Kruemelbahn/LightControl/README.md

# LightControl

...ist eine kleine Sammlung von Lichtsteuerungen (mit analoger Ansteuerung) auf meiner Modellbahn.

Nachfolgende Softwarepakete stehen unter [Software](https://github.com/Kruemelbahn/lightControl/tree/main/Software) zur Verfügung
- auf Arduino-Basis, kompiliert für ATtiny13 (für die Arduino-IDE wird das Board [MicroCore](https://github.com/MCUdude/MicroCore) verwendet):
  - [Blinken_5fach](https://github.com/Kruemelbahn/lightControl/tree/main/Software/Blinken_5fach) läßt alle Ausgänge blinken
  - [Einsatzfahrzeuge](https://github.com/Kruemelbahn/lightControl/tree/main/Software/Einsatzfahrzeuge) generiert zwei verschiedene Blinkfolgen für Einsatzfahrzeuge
- auf ATtiny13-Basis:
  - [Belebtes_Haus_mit_TV_Attiny](https://github.com/Kruemelbahn/lightControl/tree/main/Software/Belebtes_Haus_mit_TV_Attiny) simuliert ein belebtes Haus, es werden einige LEDs zufällig eine- und ausgeschaltet (Zimmerbeleuchtung), ein weiterer Ausgang simuliert einen flimmernden Fernsehgerät.
  - [Blinken](https://github.com/Kruemelbahn/lightControl/tree/main/Software/Blinken) läßt den Ausgang PB0 blinken
  - [Blitz_Blinker](https://github.com/Kruemelbahn/lightControl/tree/main/Software/Blitz_Blinker) ist die Implementierung des [FotoMichel](https://github.com/Kruemelbahn/FotoMichel) auf AVR-Basis anstelle eines PIC.
    Die Hardware ist gegenüber dem originalen FotoMichel einfacher gehalten und hat nur einen Triggereingang für die Blitzlichter.
	Sowohl die Software für den [Blitz_Blinker](https://github.com/Kruemelbahn/lightControl/tree/main/Software/Blitz_Blinker) als auch des [FotoMichel](https://github.com/Kruemelbahn/FotoMichel) sind auf diesem Lichtcomputer mit geringen Hardwareanpassungen einsetzbar, siehe in der [Dokumentation](Documentation/Lichtcomputer.pdf).
  - [LaufLicht_ATiny13](https://github.com/Kruemelbahn/LightControl/tree/main/Software/LaufLicht_ATiny13) ist die Implementierung eines Lauflichts über die Ausgänge PB0...PB4

Einige im Repository [Signalling](https://github.com/Kruemelbahn/Signalling) befindliche Softwarepakete sind auch auf dem Lichtcomputer einsetzbar. Anwendung und Einschränkungen bzw. Änderungen sind in der [Dokumentation](https://github.com/Kruemelbahn/LightControl/blob/main/Documentation/Lichtcomputer.pdf) enthalten.

Der Quellcode wird nur benötigt, wenn
- man neugierig ist
- oder den Quellcode ändern und somit neu kompilieren möchte.
Zum Kompilieren wird ein AVR-Compiler (z.B. das ATMEL-Studio bzw. die Arduino-IDE) benötigt.

Ansonsten reichen die Hex-Dateien völlig aus, diese werden in den ATtiny13 geflasht.
Die Software auf dem ATtiny13 läuft mit den Default-Fuses: low=0x6A high=0xFF

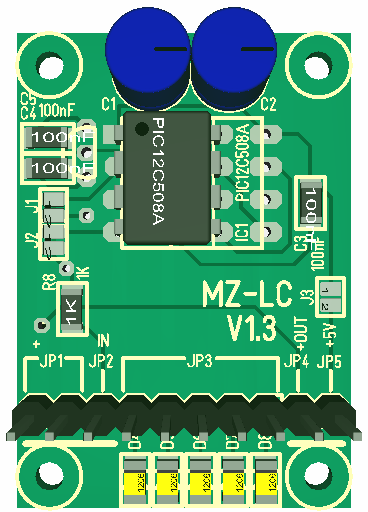
[picture p1: Images/Lichtcomputer(PIC).png]
Lichtcomputer mit PIC

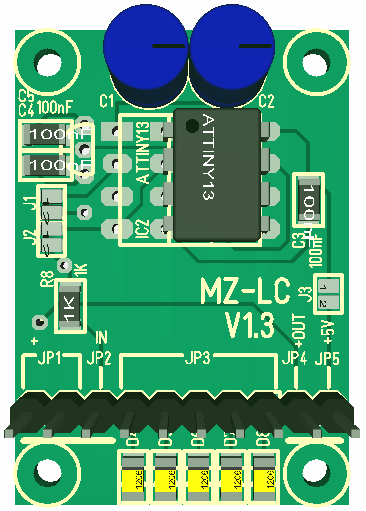
[picture p2: Images/Lichtcomputer(ATMEL).png]
Lichtcomputer mit ATTiny

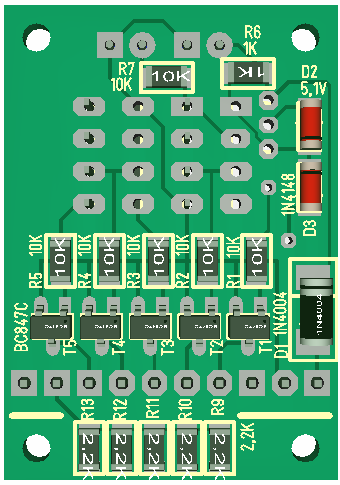
[picture p3: Images/Lichtcomputer(Unterseite).png]
Lichtcomputer (Unterseite)
