Kruemelbahn/LightControl/Documentation/README.md

# Documentation

Die Dokumentation wurde passend für die neue Platine erstellt.
