Kruemelbahn/LightControl/Hardware/Lichtcomputer_LED.pdf

i 2

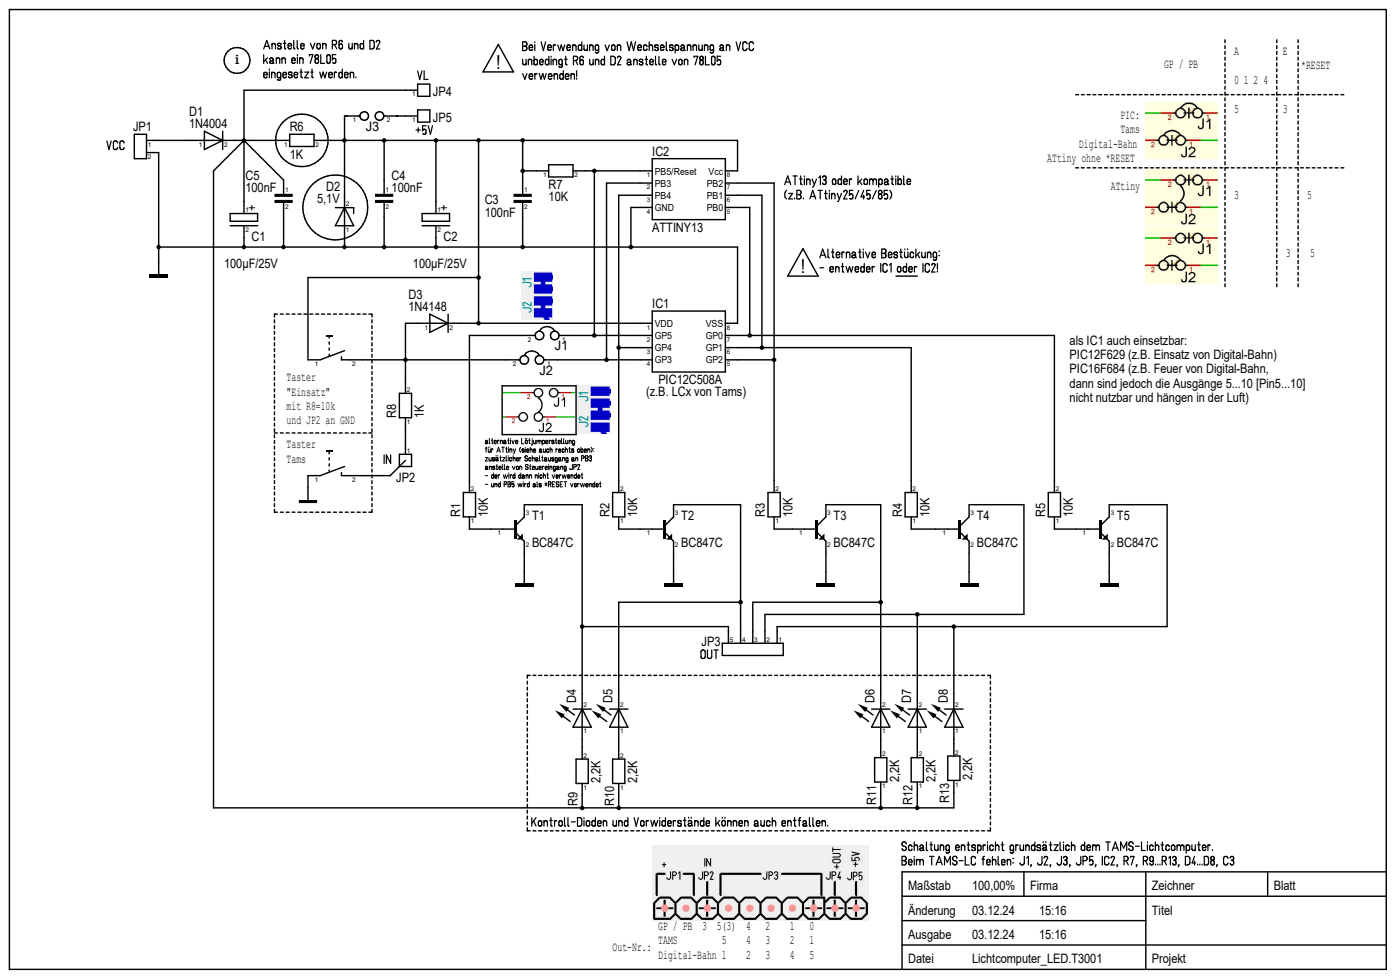
[picture p20: page 1]

als IC1 auch einsetzbar:
PIC12F629 (z.B. Einsatz von Digital-Bahn)
PIC16F684 (z.B. Feuer von Digital-Bahn,
dann sind jedoch die Ausgänge 5...10 [Pin5...10]
