Kruemelbahn/LightControl/Software/Blitz_Blinker/Hardware/Blitz_Blinker.pdf

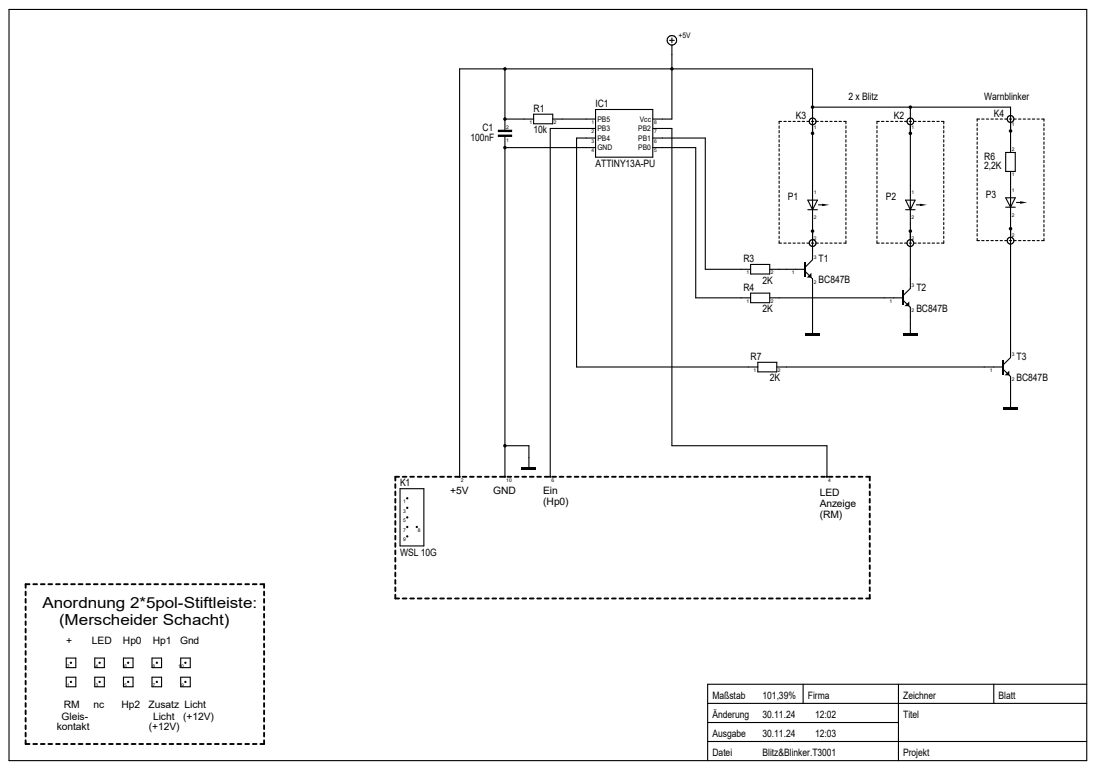
[picture p21: page 1]
